hribalj/Solidworks_Assignments/Arbor_Press_ASSY.SLDASM

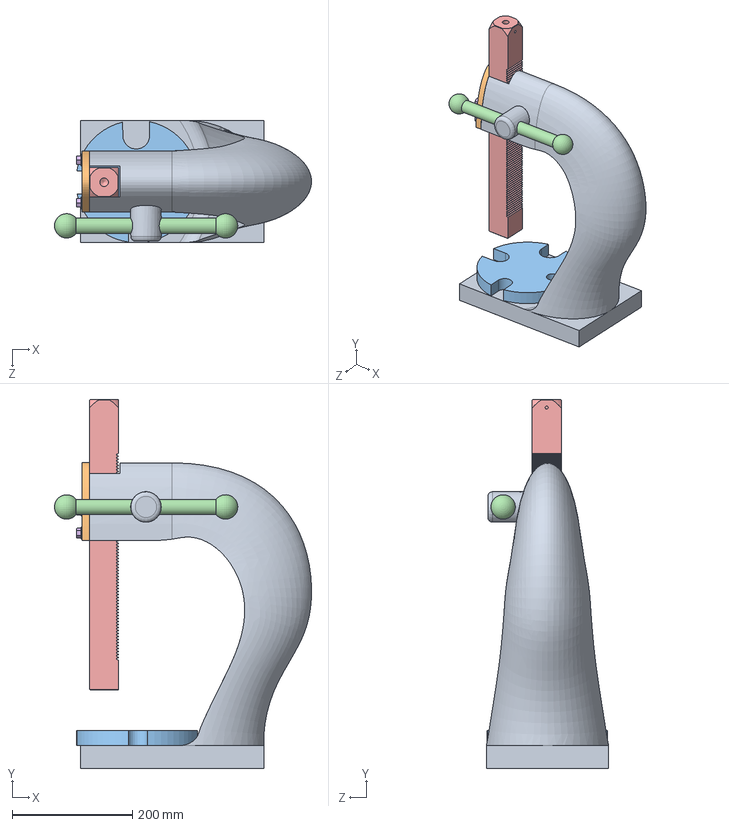
[picture p5: CAD file, 2019-01-09]
Arbor_Press_ASSY.SLDASM
427.4 x 613.3 x 203.2 mm
ArborPress3noFin
Face_Plate
Base_Plate
Crank_Shaft
Gear_rack
hex washer screw_ai x 4
