hribalj/Solidworks_Assignments/Gear_rack.SLDPRT

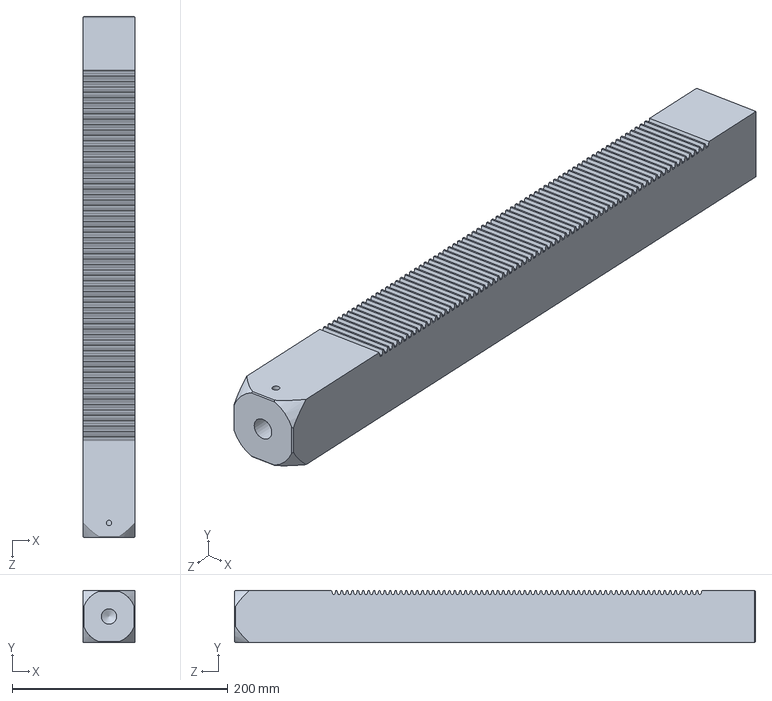
[picture p6: CAD file, 2019-01-09]
Gear_rack.SLDPRT
48.3 x 48.3 x 482.6 mm
