hribalj/Solidworks_Assignments/Crank_Shaft.SLDPRT

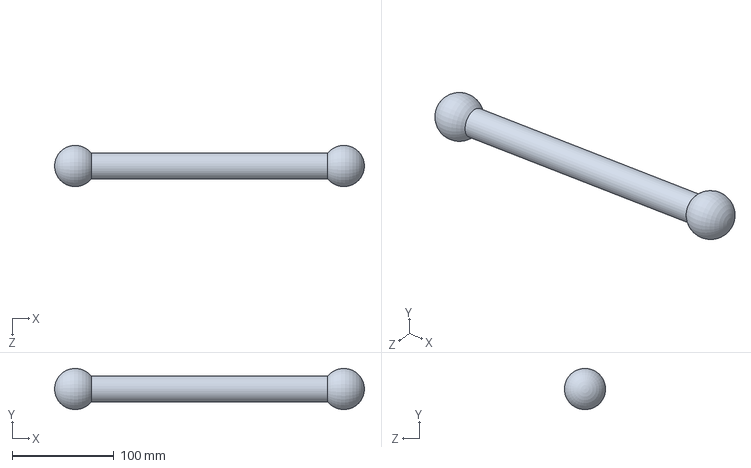
[picture p7: CAD file, 2019-01-09]
Crank_Shaft.SLDPRT
304.8 x 40.5 x 40.5 mm
