hribalj/Solidworks_Assignments/Face_Plate.SLDPRT

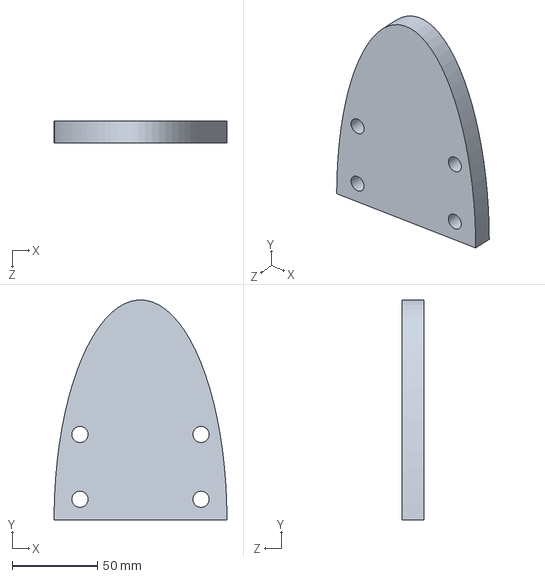
[picture p8: CAD file, 2019-01-09]
Face_Plate.SLDPRT
101.6 x 129.2 x 12.7 mm
