hribalj/Solidworks_Assignments/Base_Plate.SLDPRT

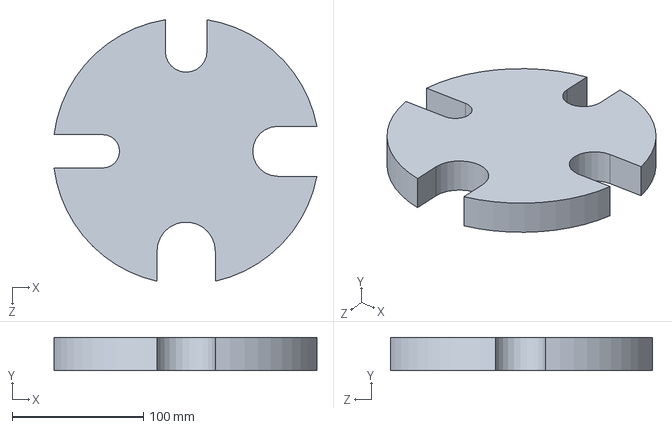
[picture p9: CAD file, 2019-01-09]
Base_Plate.SLDPRT
200.6 x 25.4 x 199.5 mm
