hribalj/Solidworks_Assignments/ArborPress3noFin.SLDPRT

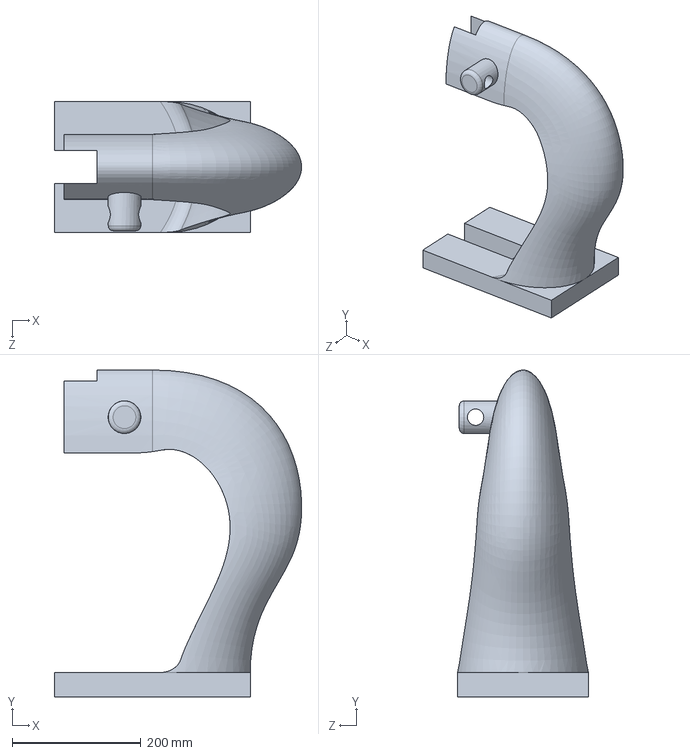
[picture p10: CAD file, 2019-01-09]
ArborPress3noFin.SLDPRT
384.2 x 508.0 x 203.2 mm
