hribalj/Solidworks_Assignments/(list of files, cad)

Other CAD files:
ArborPress3noFin_PART_DRWING.SLDDRW
Base_Plate_PART_DRWING.SLDDRW
Crank_Shaft_PART_DRWING.SLDDRW
Face_Plate_DRWING.SLDDRW
Gear_rack_PART_DRWING.SLDDRW
