hribalj/Solidworks_Assignments/Arbor_Press_Installation.PDF

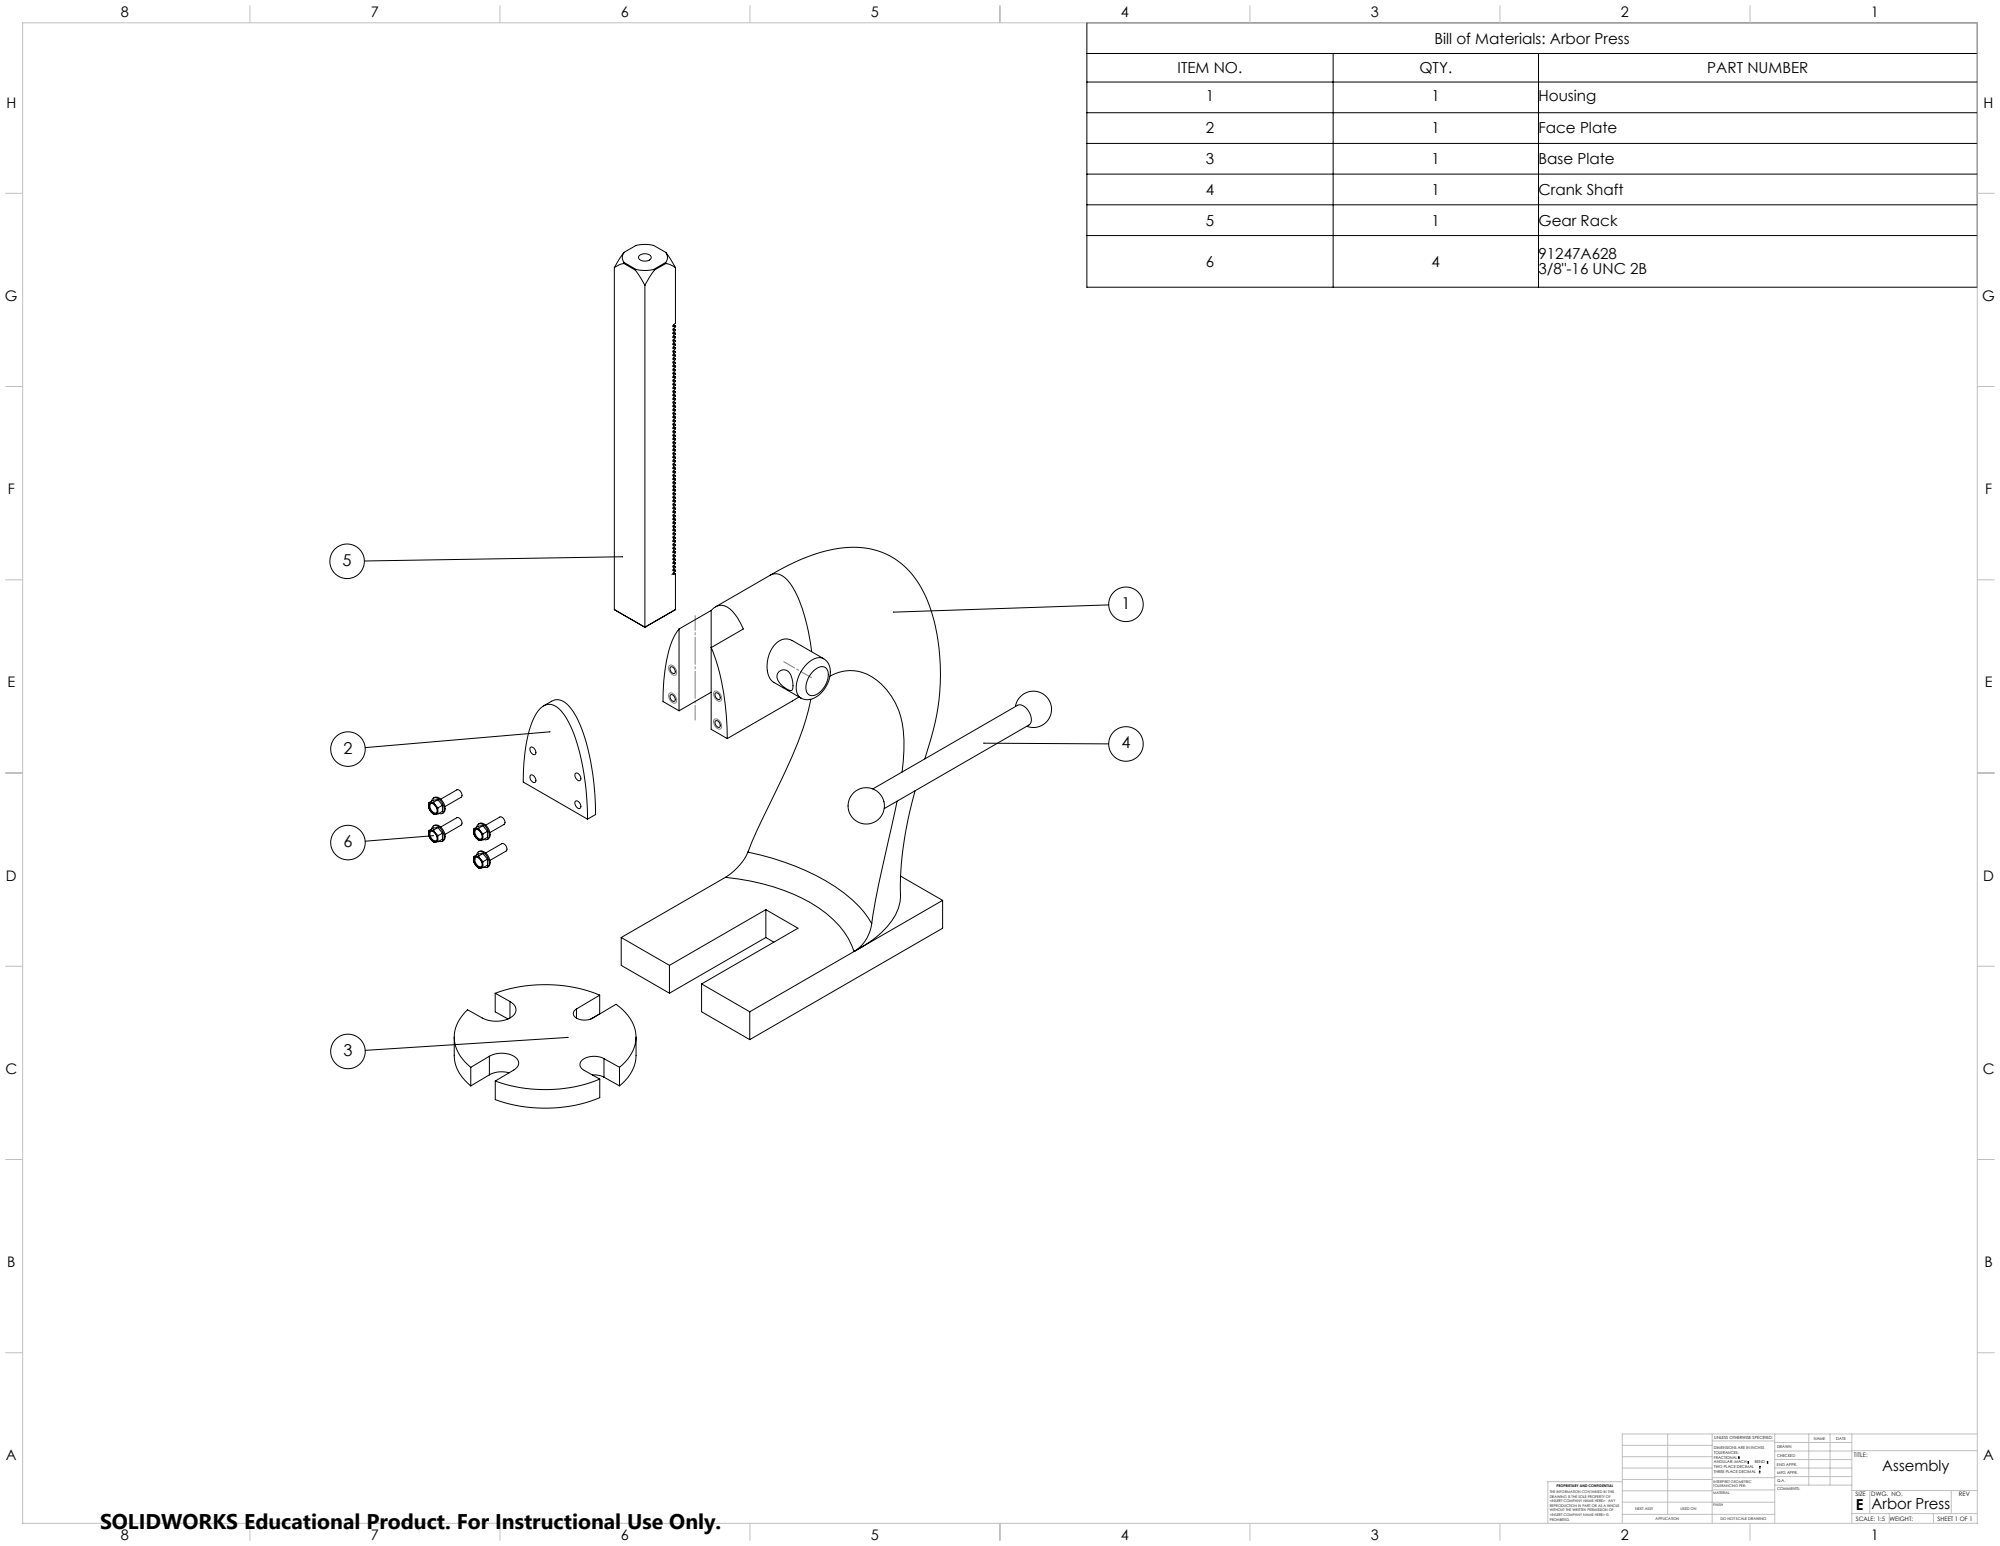
[picture p11: page 1]
3/8"-16 UNC 2B

Bill of Materials: Arbor Press

ITEM NO. | QTY. | PART NUMBER
1 | 1 | Housing
2 | 1 | Face Plate
3 | 1 | Base Plate
4 | 1 | Crank Shaft
5 | 1 | Gear Rack
6 | 4 | 91247A628

UNLESS OTHERWISE SPECIFIED: | | NAME | DATE
DIMENSIONS ARE IN INCHES TOLERANCES: FRACTIONAL ANGULAR: MACH BEND TWO PLACE DECIMAL THREE PLACE DECIMAL | DRAWN

SOLIDWORKS Educational Product. For Instructional Use Only.

CHECKED | | | TITLE: Assembly

ENG APPR.
MFG APPR.

INTERPRET GEOMETRIC TOLERANCING PER: | Q.A.
MATERIAL | | SIZE E | DWG. NO. Arbor Press | REV

PROPRIETARY AND CONFIDENTIAL
THE INFORMATION CONTAINED IN THIS
DRAWING IS THE SOLE PROPERTY OF
<INSERT COMPANY NAME HERE>. ANY
REPRODUCTION IN PART OR AS A WHOLE
WITHOUT THE WRITTEN PERMISSION OF
<INSERT COMPANY NAME HERE> IS
PROHIBITED.

NEXT ASSY | USED ON | FINISH

APPLICATION | DO NOT SCALE DRAWING | | SCALE: 1:5 | WEIGHT: | SHEET 1 OF 1
