hribalj/Solidworks_Assignments/Base_Plate.PDF

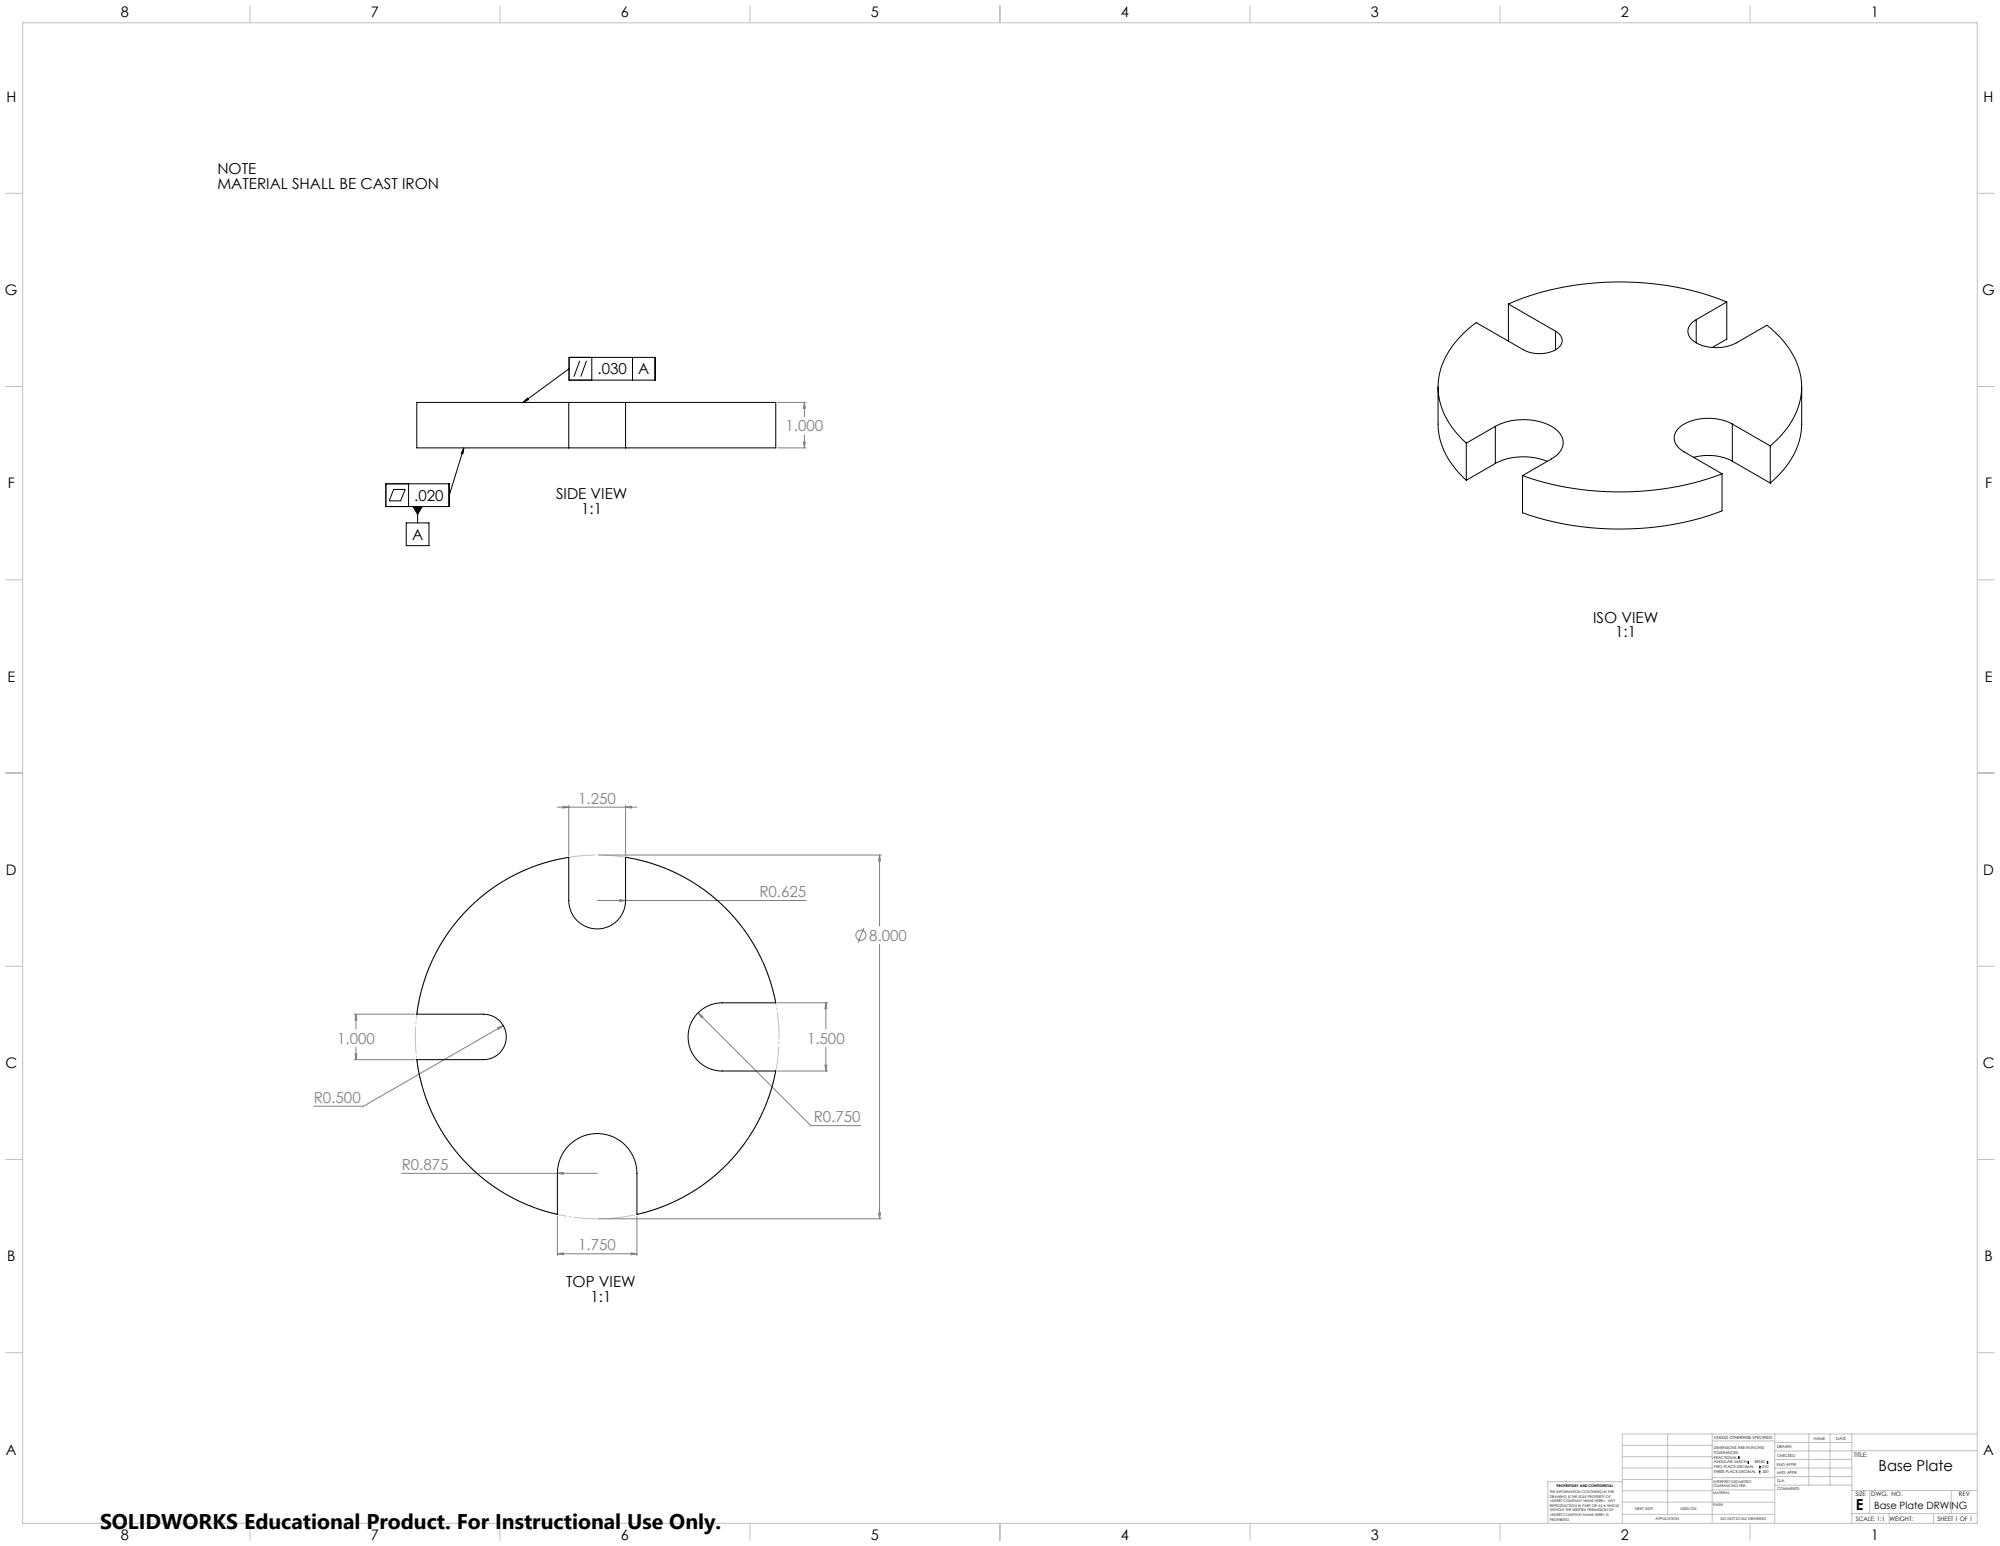
[picture p12: page 1]
SIDE VIEW; ISO VIEW; TOP VIEW

NOTE
MATERIAL SHALL BE CAST IRON

UNLESS OTHERWISE SPECIFIED: | | NAME | DATE
DIMENSIONS ARE IN INCHES TOLERANCES: FRACTIONAL ANGULAR: MACH BEND TWO PLACE DECIMAL .010 THREE PLACE DECIMAL .001 | DRAWN

SOLIDWORKS Educational Product. For Instructional Use Only.

CHECKED | | | TITLE: Base Plate

ENG APPR.
MFG APPR.

INTERPRET GEOMETRIC TOLERANCING PER: | Q.A.
MATERIAL | | SIZE E | DWG. NO. Base Plate DRWING | REV

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

NEXT ASSY | USED ON | FINISH

APPLICATION | DO NOT SCALE DRAWING | | SCALE: 1:1 | WEIGHT: | SHEET 1 OF 1
