hribalj/Solidworks_Assignments/Face_plate.PDF

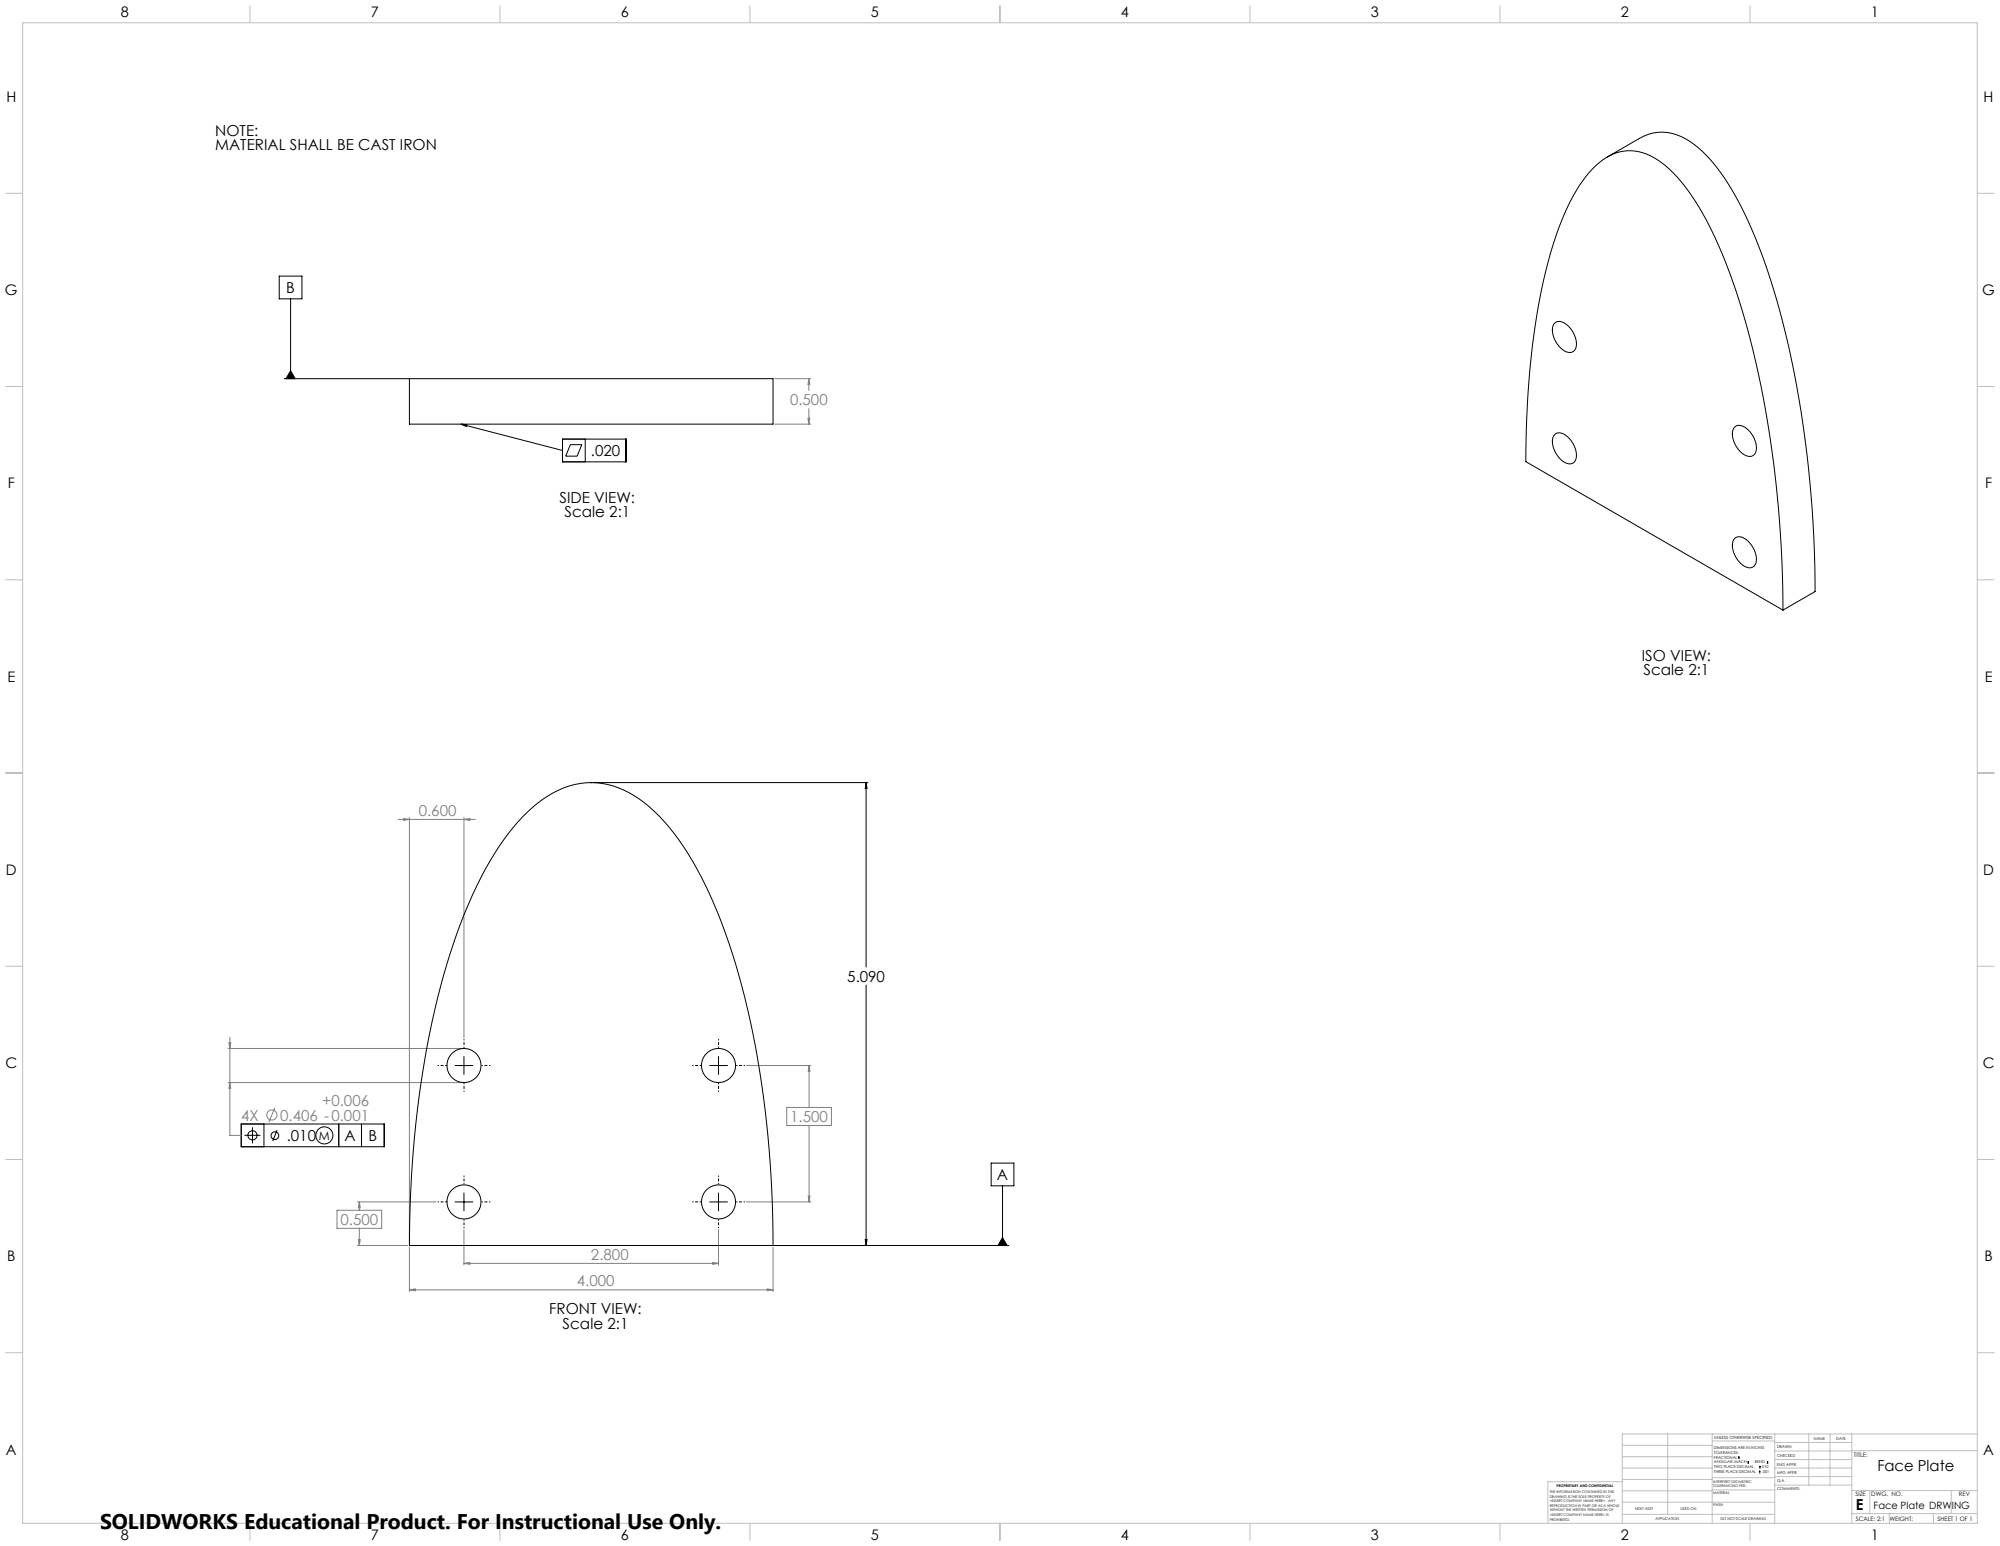
[picture p13: page 1]
ISO VIEW: Scale 2:1; SIDE VIEW: Scale 2:1; FRONT VIEW: Scale 2:1

NOTE:
MATERIAL SHALL BE CAST IRON

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

SOLIDWORKS Educational Product. For Instructional Use Only.

CHECKED | | | TITLE: Face Plate

ENG APPR.
MFG APPR.

INTERPRET GEOMETRIC TOLERANCING PER: | Q.A.
MATERIAL | | SIZE E | DWG. NO. Face Plate DRWING | REV

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

NEXT ASSY | USED ON | FINISH

APPLICATION | DO NOT SCALE DRAWING | | SCALE: 2:1 | WEIGHT: | SHEET 1 OF 1
