hribalj/Solidworks_Assignments/Gear_rack.PDF

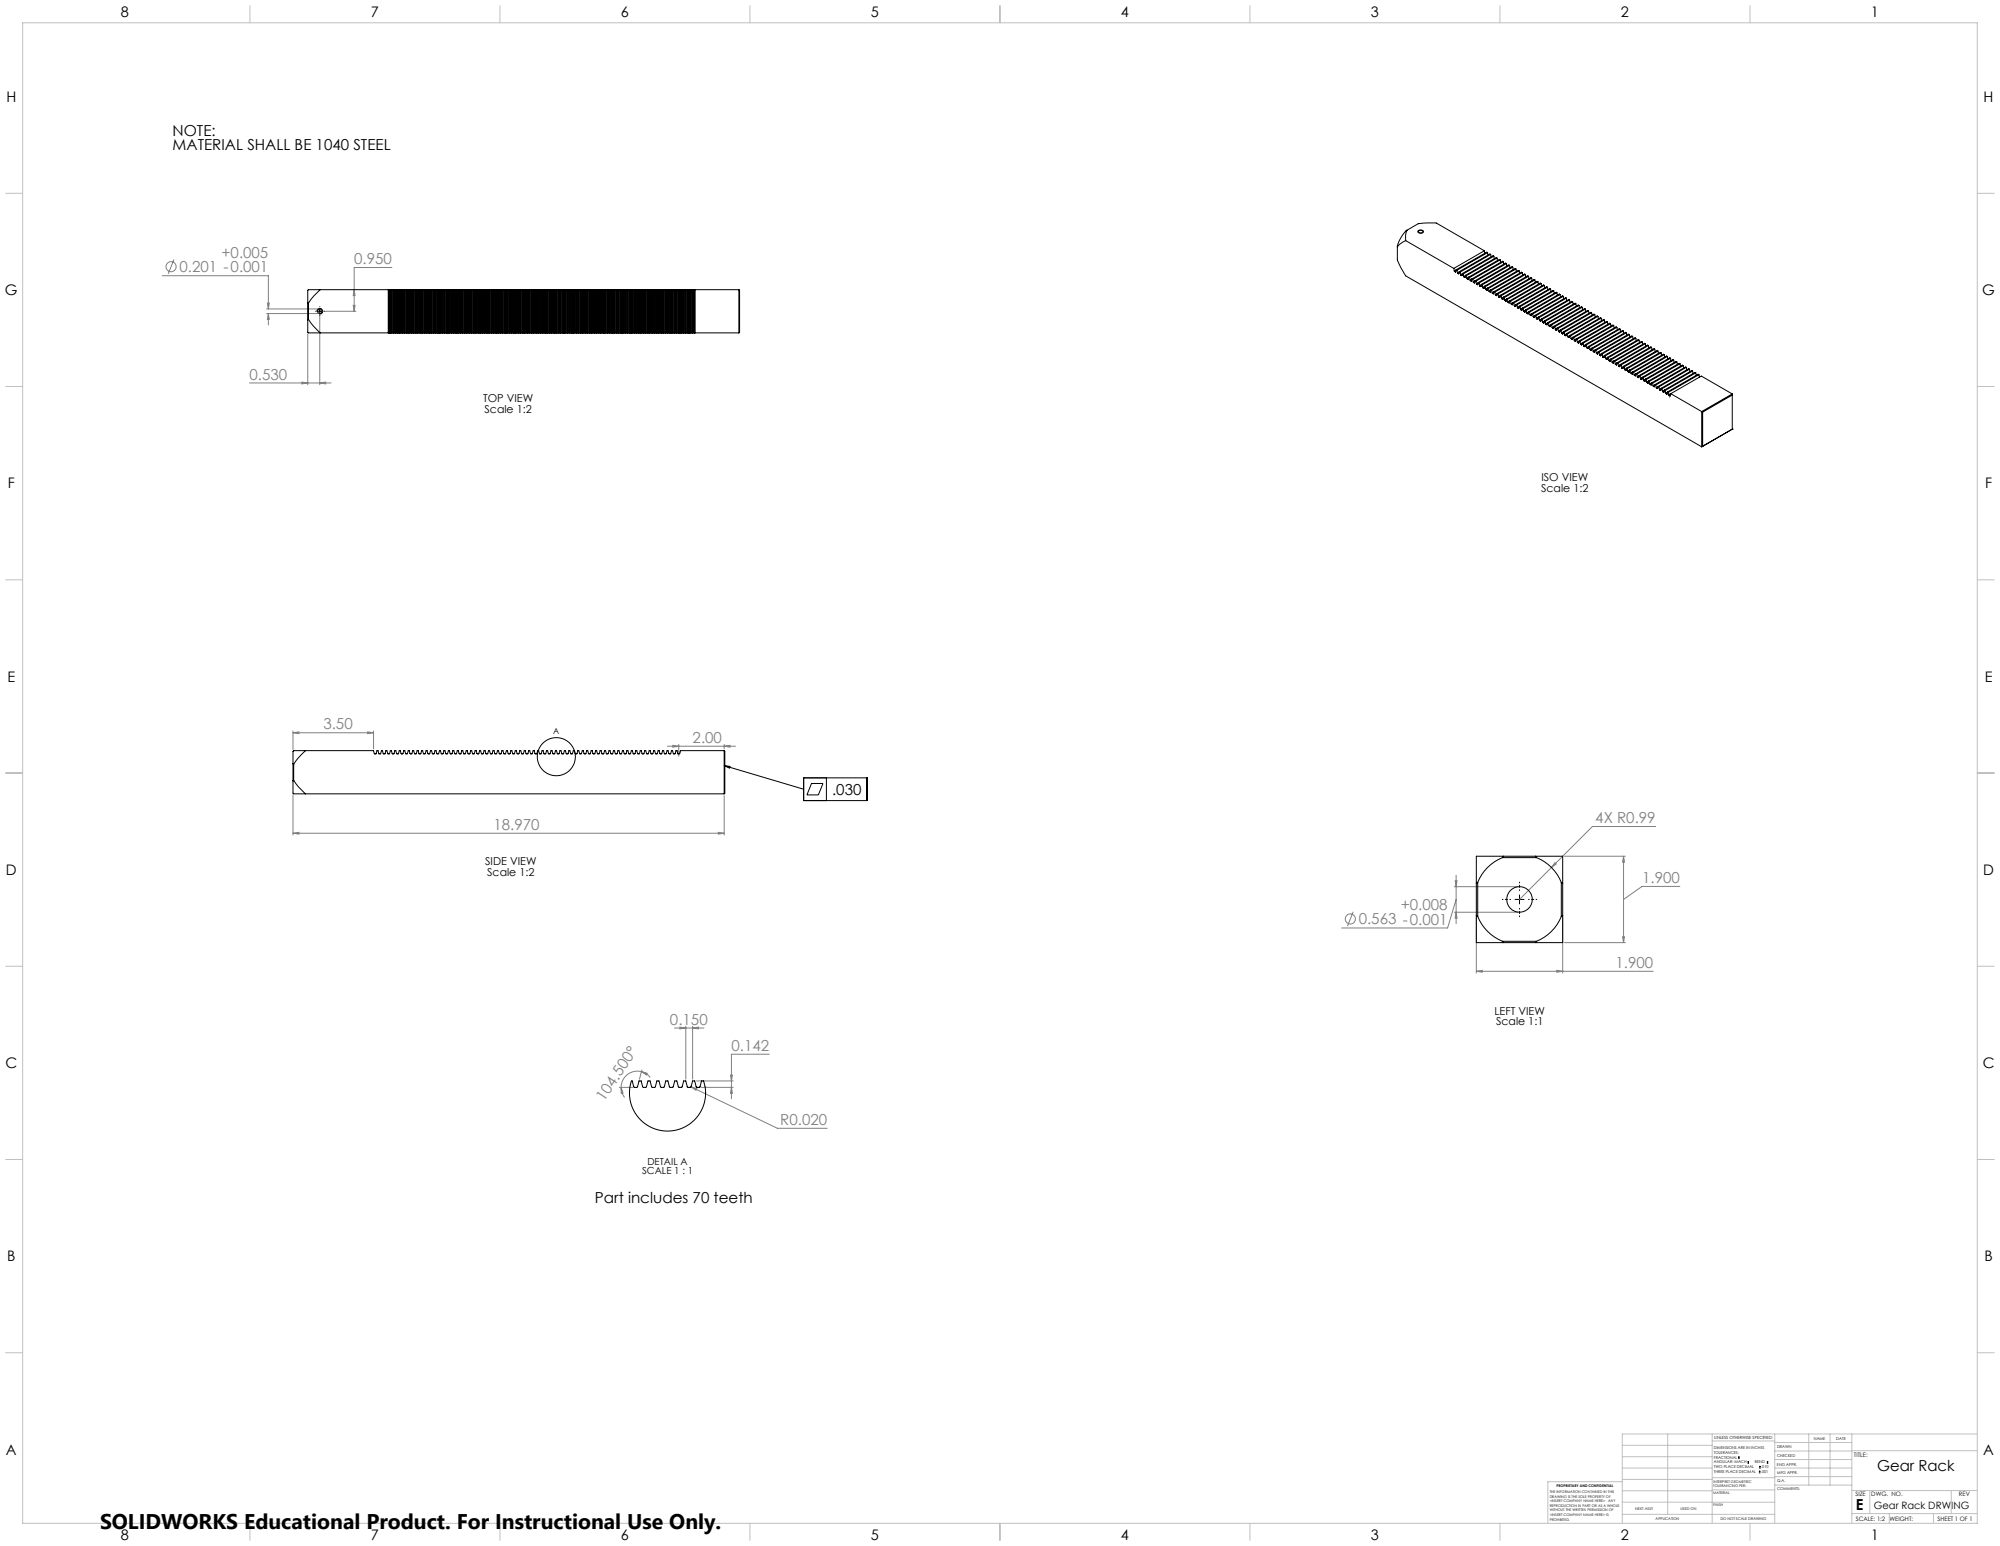
[picture p14: page 1]
ISO VIEW Scale 1:2; TOP VIEW Scale 1:2; SIDE VIEW Scale 1:2; LEFT VIEW Scale 1:1

NOTE:
MATERIAL SHALL BE 1040 STEEL

DETAIL A
SCALE 1 : 1
Part includes 70 teeth

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

SOLIDWORKS Educational Product. For Instructional Use Only.

CHECKED | | | TITLE: Gear Rack

ENG APPR.
MFG APPR.

INTERPRET GEOMETRIC TOLERANCING PER: | Q.A.
MATERIAL | | SIZE E | DWG. NO. Gear Rack DRWING | REV

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

NEXT ASSY | USED ON | FINISH

APPLICATION | DO NOT SCALE DRAWING | | SCALE: 1:2 | WEIGHT: | SHEET 1 OF 1
