hribalj/Solidworks_Assignments/Housing.PDF

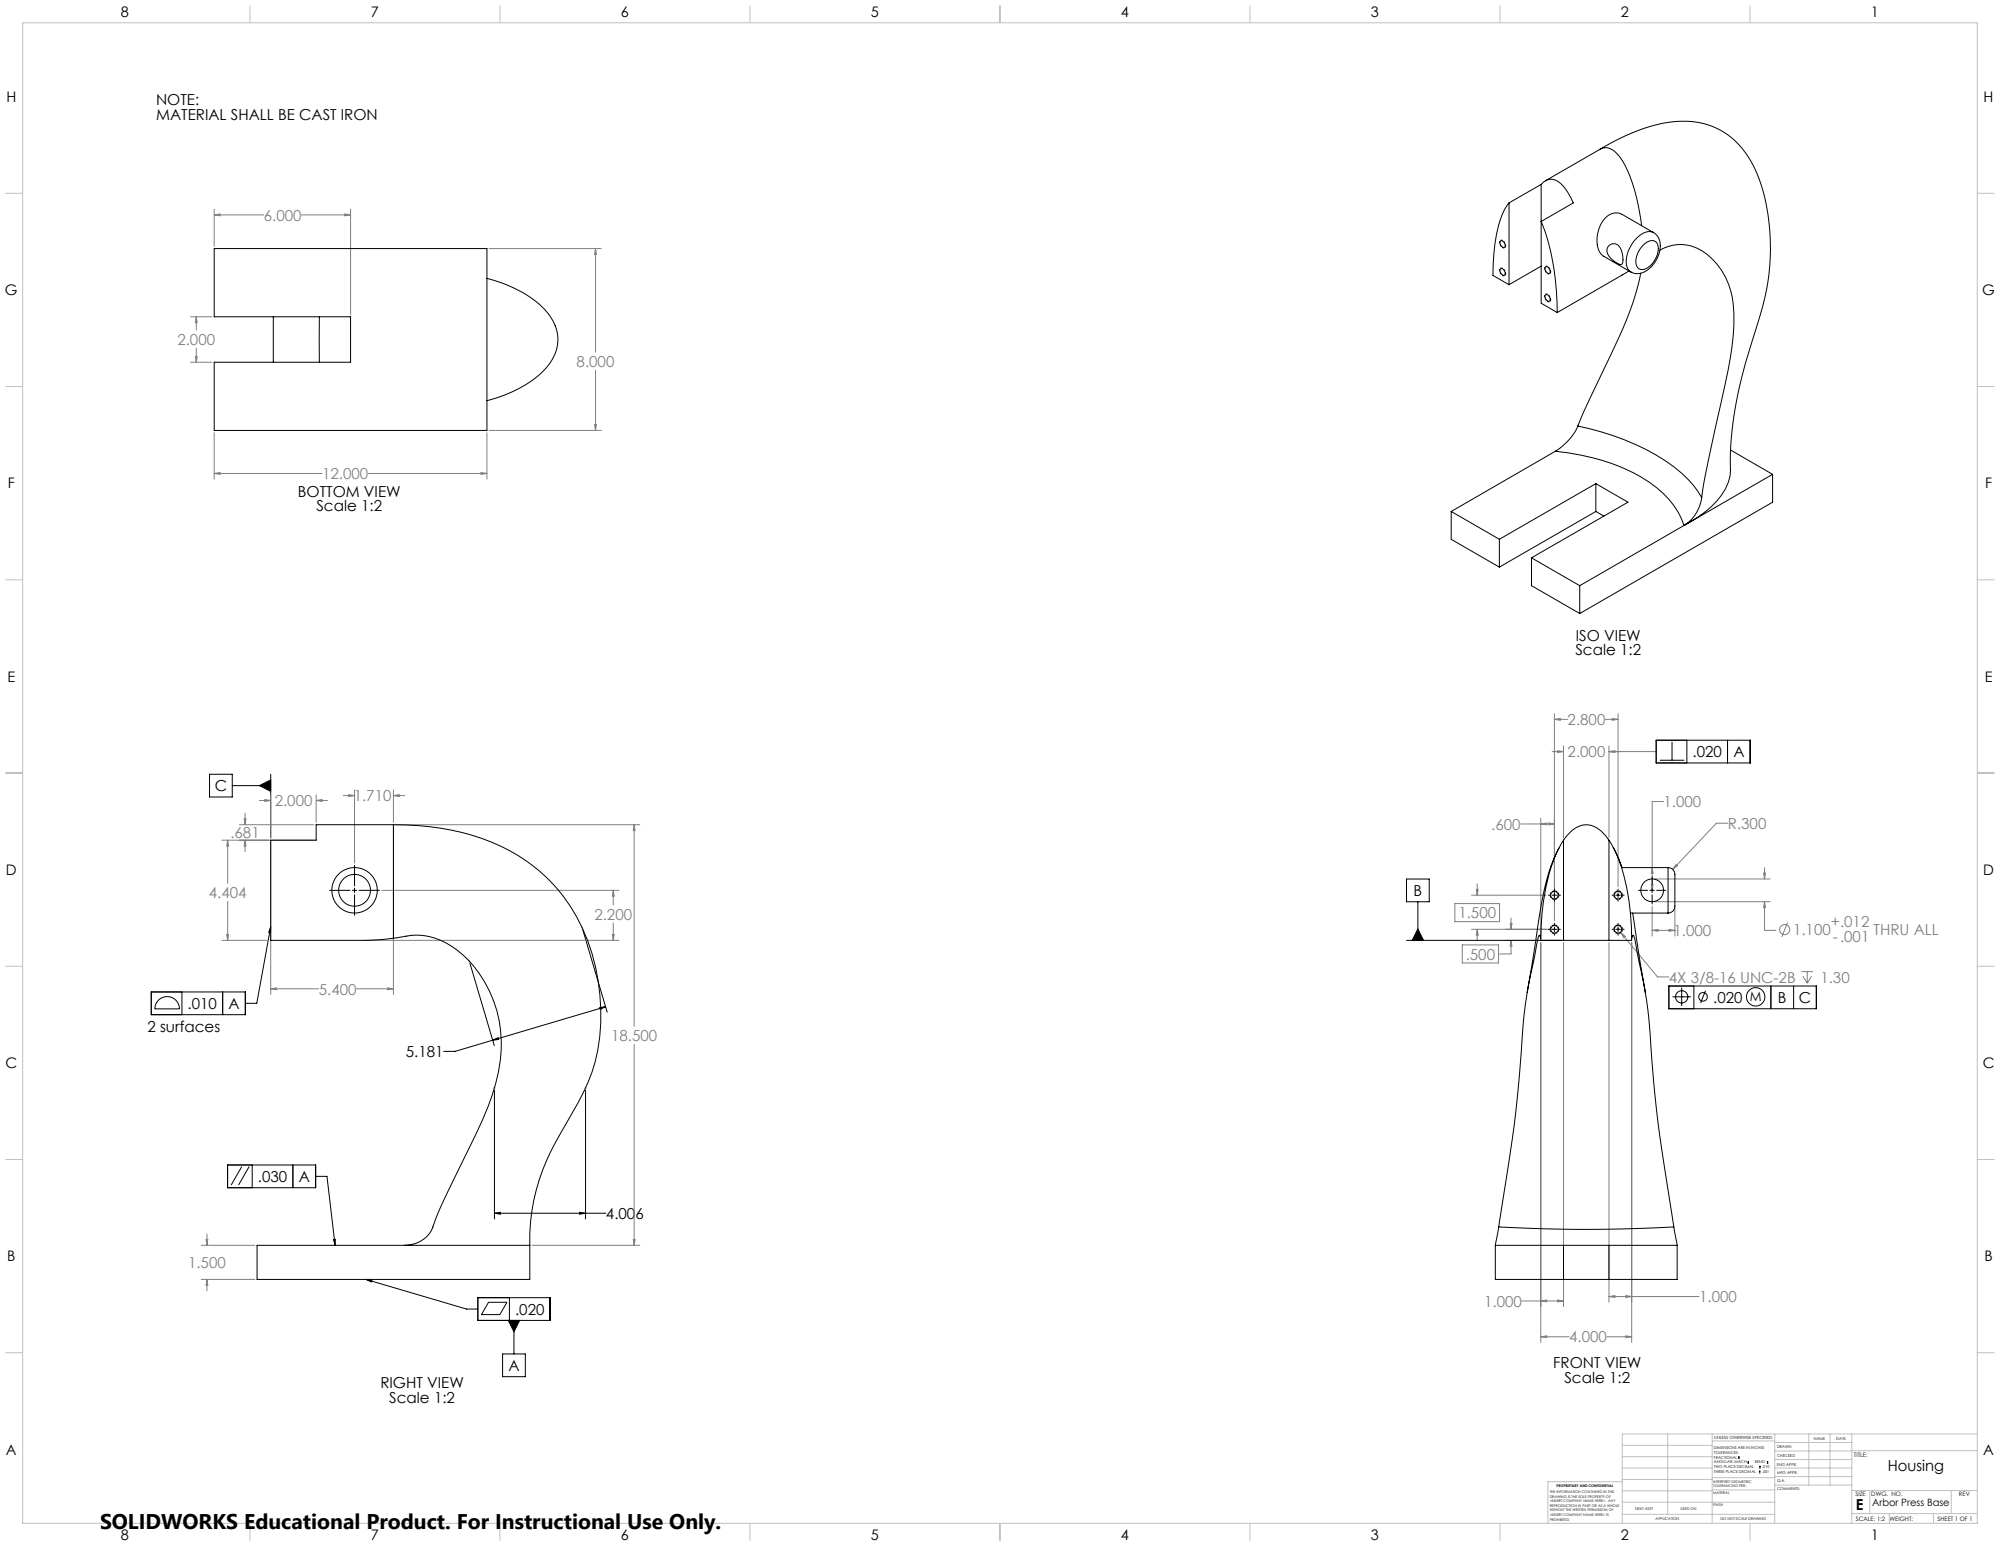
[picture p15: page 1]
ISO VIEW Scale 1:2; 4X 3/8-16 UNC-2B 1.30; .001 THRU ALL; BOTTOM VIEW Scale 1:2; RIGHT VIEW Scale 1:2; FRONT VIEW Scale 1:2; 2 surfaces

NOTE:
MATERIAL SHALL BE CAST IRON

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

SOLIDWORKS Educational Product. For Instructional Use Only.

CHECKED | | | TITLE: Housing

ENG APPR.
MFG APPR.

INTERPRET GEOMETRIC TOLERANCING PER: | Q.A.
MATERIAL | | SIZE E | DWG. NO. Arbor Press Base | REV

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

NEXT ASSY | USED ON | FINISH

APPLICATION | DO NOT SCALE DRAWING | | SCALE: 1:2 | WEIGHT: | SHEET 1 OF 1
